solispensa/Chocotone/reference/GP5Editor_files/arial-yellow.png

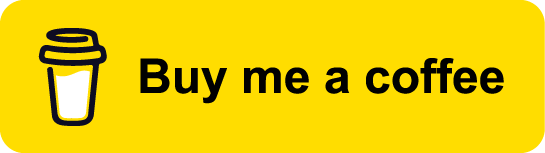
reference/GP5Editor_files/arial-yellow.png
