solispensa/Chocotone/installer.html

# CHOCOTONE

ESP32 FIRMWARE INSTALLER

## Install Firmware

Connect your ESP32 board via USB and click the button below.

Firmware Version:

🚀 Install Chocotone

⚠️

Your browser doesn't support Web Serial. Use Chrome, Edge, or Brave on desktop.

🔒

Serial access blocked. This page must be served over HTTPS or localhost.

📋 What You Need

💻 Chrome, Edge, or Brave

🔌 USB data cable

📦 ESP32 dev board

🪟 Win / Mac / Linux

📝 How It Works

1

### Connect ESP32

Plug your ESP32 board into your computer with a USB data cable.

2

### Select Version

Choose a firmware version from the dropdown (latest recommended).

3

### Click Install

Click the button and select your ESP32 from the list.

4

### Done!

Wait ~30s. Your controller is ready when OLED shows "Chocotone".

🔧 Troubleshooting

ESP32 not showing in the device list

Use a data cable, not charge-only. Try another USB port. On Windows, install CP210x drivers (https://www.silabs.com/developers/usb-to-uart-bridge-vcp-drivers).

Installation fails or times out

Hold the BOOT button on your ESP32 while clicking "Install". Release after programming starts.

"Failed to connect" error

Close other programs using the serial port (Arduino IDE, etc.). Unplug/replug the ESP32 and try again.

Browser shows "Not supported"

Web Serial only works in Chrome, Edge, Brave, Arc, or Opera. Firefox and Safari are not supported.

### 📥 Alternative Download

Prefer to flash manually with Arduino IDE or esptool?

⬇️ Download .bin

GitHub (https://github.com/solispensa/Chocotone) · Beginner's Guide · Community (https://www.facebook.com/groups/1950814575859830/)

Made with ❤️ for the MIDI community
