solispensa/Chocotone/web_tools/installer.html

# CHOCOTONE

ESP32 FIRMWARE INSTALLER

## Install Firmware

Connect your ESP32 board via USB and click the button below.

Firmware Version:

🚀 Install Chocotone

⚠️

Your browser doesn't support Web Serial. Use Chrome, Edge, or Brave.

🔒

Serial access blocked. Must serve over HTTPS or localhost.

📋 What You Need

💻 Chrome / Edge / Brave

🔌 USB data cable

📦 ESP32 dev board

🪟 Win / Mac / Linux

📝 How It Works

1

### Connect ESP32

Plug your ESP32 board into your computer with a USB data cable.

2

### Select Version

Choose the latest firmware version from the dropdown.

3

### Click Install

Click the button and select your ESP32 from the list.

4

### Done!

Wait ~30s. Controller is ready when OLED shows "Chocotone".

🔧 Troubleshooting

ESP32 not showing in list

Use a data cable, not charge-only. Try another USB port. Windows users: install CP210x drivers (https://www.silabs.com/developers/usb-to-uart-bridge-vcp-drivers).

Installation fails / Packet Error

Hold the BOOT button on your ESP32 while clicking "Install". Release after "Erasing" appears.

"Failed to connect"

Close Arduino IDE or other serial monitors. Unplug/replug the ESP32 and try again.

### 📥 Manual Download

Flash manually with esptool?

⬇️ Download .bin

📝 Editor · 🎮 Virtual Chocotone · 📦 GitHub (https://github.com/solispensa/Chocotone)

Beginner's Guide · Community (https://www.facebook.com/groups/1950814575859830/)

Made with ❤️ for the MIDI community
