solispensa/Chocotone/Chocotone_v1.5.0_beta/Storage.cpp

#include "Storage.h"
#include "AnalogInput.h"
#include "DefaultPresets.h"
#include <SPIFFS.h>

#define PRESETS_NAMESPACE "midi_presets"
#define CONFIG_VERSION_KEY "cfg_ver"
#define CURRENT_CONFIG_VERSION 4 // v4: Added Expression Pedal support

// ============================================
// SYSTEM SETTINGS (v2)
// ============================================

void saveSystemSettings() {
  Serial.println("=== Saving System Settings (v2) ===");

  // Use a FRESH LOCAL Preferences object to avoid global state issues
  Preferences prefs;
  if (!prefs.begin(PRESETS_NAMESPACE, false)) {
    Serial.println("ERROR: Cannot open presets namespace for system settings!");
    return;
  }

  // Write version marker (prefixed to avoid collision with preset version)
  prefs.putInt("sys_ver", CURRENT_CONFIG_VERSION);

  // UI Settings (prefixed with "s_" to distinguish from preset data)
  prefs.putInt("s_font", buttonNameFontSize);
  prefs.putInt("s_ledOn", ledBrightnessOn);
  prefs.putInt("s_ledDim", ledBrightnessDim);
  prefs.putInt("s_ledTap", ledBrightnessTap);
  prefs.putInt("s_debounce", buttonDebounce);
  prefs.putInt("s_rhythm", rhythmPattern);
  prefs.putInt("s_delay", currentDelayType);
  prefs.putInt("s_preset", currentPreset);
  prefs.putInt("s_presCnt", presetCount); // v1.5.2: Preset count (1-8)

  // SystemConfig struct fields
  prefs.putString("s_bleName", systemConfig.bleDeviceName);
  prefs.putString("s_apSSID", systemConfig.apSSID);
  prefs.putString("s_apPass", systemConfig.apPassword);
  prefs.putInt("s_btnCount", systemConfig.buttonCount);
  prefs.putBytes("s_btnPins", systemConfig.buttonPins,
                 sizeof(systemConfig.buttonPins));
  prefs.putInt("s_ledPin", systemConfig.ledPin);
  prefs.putInt("s_encA", systemConfig.encoderA);
  prefs.putInt("s_encB", systemConfig.encoderB);
  prefs.putInt("s_encBtn", systemConfig.encoderBtn);
  prefs.putBool("s_wifiBoot", systemConfig.wifiOnAtBoot);
  prefs.putUChar("s_bleMode", (uint8_t)systemConfig.bleMode);
  prefs.putUChar("s_ledsPerBtn", systemConfig.ledsPerButton);
  prefs.putBytes("s_ledMap", systemConfig.ledMap, sizeof(systemConfig.ledMap));

  // OLED Configuration (v1.5)
  prefs.putBytes("s_oledCfg", &oledConfig, sizeof(OledConfig));

  // v1.5 Additions
  prefs.putBytes("s_muxCfg", &systemConfig.multiplexer,
                 sizeof(MultiplexerConfig));
  prefs.putUChar("s_target", (uint8_t)systemConfig.targetDevice);
  prefs.putUChar("s_midiCh", systemConfig.midiChannel);
  prefs.putBool("s_debugAin", systemConfig.debugAnalogIn);
  prefs.putUChar("s_ainCount", systemConfig.analogInputCount);
  prefs.putUChar("s_battPin", systemConfig.batteryAdcPin); // v1.5: Battery ADC
  prefs.putInt("s_batMax", batteryAdcMax); // Auto-calibrated max
  prefs.putInt("s_batMin", batteryAdcMin); // Auto-calibrated min

  Serial.printf("Saved OLED config: type=%d, rotation=%d\n", oledConfig.type,
                oledConfig.rotation);

  prefs.end();
  Serial.println("=== System Settings Saved (v2) ===");
}

void loadSystemSettings() {
  // Use a FRESH LOCAL Preferences object (consistent with saveSystemSettings)
  yield(); // Feed watchdog before NVS operation
  Preferences prefs;
  if (!prefs.begin(PRESETS_NAMESPACE, true)) {
    Serial.println("ERROR: Cannot open presets namespace for loading!");
    return;
  }

  // Check for new format (sys_ver key) or old format
  int version = prefs.getInt("sys_ver", 0); // New unified format
  if (version == 0) {
    // Try old format - might not exist yet
    version = 1;
  }
  Serial.printf("Loading System Settings (v%d)...\n", version);

  // UI Settings (prefixed keys in new format)
  buttonNameFontSize = prefs.getInt("s_font", 5);
  ledBrightnessOn = prefs.getInt("s_ledOn", 220);
  ledBrightnessDim = prefs.getInt("s_ledDim", 20);
  ledBrightnessTap = prefs.getInt("s_ledTap", 240);
  buttonDebounce = prefs.getInt("s_debounce", 120);
  rhythmPattern = prefs.getInt("s_rhythm", 0);
  if (rhythmPattern < 0 || rhythmPattern > 3)
    rhythmPattern = 0;
  currentDelayType = prefs.getInt("s_delay", 0);
  currentPreset = prefs.getInt("s_preset", 0);
  if (currentPreset < 0 || currentPreset >= CHOCO_MAX_PRESETS)
    currentPreset = 0;
  presetCount = prefs.getInt("s_presCnt", 4); // v1.5.2: Default 4 presets
  if (presetCount < 1)
    presetCount = 1;
  if (presetCount > CHOCO_MAX_PRESETS)
    presetCount = CHOCO_MAX_PRESETS;

  // SystemConfig fields (prefixed keys)
  String s_bleName = prefs.getString("s_bleName", DEFAULT_BLE_NAME);
  strncpy(systemConfig.bleDeviceName, s_bleName.c_str(), 23);
  systemConfig.bleDeviceName[23] = '\0';

  String s_ssid = prefs.getString("s_apSSID", DEFAULT_AP_SSID);
  strncpy(systemConfig.apSSID, s_ssid.c_str(), 23);
  systemConfig.apSSID[23] = '\0';

  String s_pass = prefs.getString("s_apPass", DEFAULT_AP_PASS);
  strncpy(systemConfig.apPassword, s_pass.c_str(), 15);
  systemConfig.apPassword[15] = '\0';

  systemConfig.buttonCount = prefs.getInt("s_btnCount", DEFAULT_BUTTON_COUNT);
  if (systemConfig.buttonCount < 4)
    systemConfig.buttonCount = 4;
  if (systemConfig.buttonCount > MAX_BUTTONS)
    systemConfig.buttonCount = MAX_BUTTONS;

  prefs.getBytes("s_btnPins", systemConfig.buttonPins,
                 sizeof(systemConfig.buttonPins));
  systemConfig.ledPin = prefs.getInt("s_ledPin", NEOPIXEL_PIN);
  systemConfig.encoderA = prefs.getInt("s_encA", DEFAULT_ENCODER_A);
  systemConfig.encoderB = prefs.getInt("s_encB", DEFAULT_ENCODER_B);
  systemConfig.encoderBtn = prefs.getInt("s_encBtn", DEFAULT_ENCODER_BTN);
  systemConfig.wifiOnAtBoot = prefs.getBool("s_wifiBoot", false);
  systemConfig.bleMode = (BleMode)prefs.getUChar("s_bleMode", BLE_CLIENT_ONLY);
  systemConfig.ledsPerButton = prefs.getUChar("s_ledsPerBtn", 1);

  // Load ledMap or use defaults
  if (prefs.getBytesLength("s_ledMap") == sizeof(systemConfig.ledMap)) {
    prefs.getBytes("s_ledMap", systemConfig.ledMap,
                   sizeof(systemConfig.ledMap));
  } else {
    // Default ledMap: {0, 1, 2, 3, 7, 6, 5, 4, 8, 9, 10, 11...}
    uint8_t defaultMap[MAX_BUTTONS] = {0, 1, 2,  3,  7,  6,  5,  4,
                                       8, 9, 10, 11, 12, 13, 14, 15};
    memcpy(systemConfig.ledMap, defaultMap, sizeof(systemConfig.ledMap));
  }

  // Load OLED Configuration (v1.5)
  if (prefs.getBytesLength("s_oledCfg") == sizeof(OledConfig)) {
    prefs.getBytes("s_oledCfg", &oledConfig, sizeof(OledConfig));
    Serial.printf("Loaded OLED config: type=%d, rotation=%d\n", oledConfig.type,
                  oledConfig.rotation);
  } else {
    Serial.println("Using default OLED config (128x64)");
  }

  // Load Multiplexer Configuration (v1.5)
  if (prefs.getBytesLength("s_muxCfg") == sizeof(MultiplexerConfig)) {
    prefs.getBytes("s_muxCfg", &systemConfig.multiplexer,
                   sizeof(MultiplexerConfig));
  } else {
    systemConfig.multiplexer.enabled = false;
    for (int i = 0; i < MAX_BUTTONS; i++)
      systemConfig.multiplexer.buttonChannels[i] = -1;
  }

  systemConfig.targetDevice = (DeviceType)prefs.getUChar("s_target", 0);
  systemConfig.midiChannel = prefs.getUChar("s_midiCh", 1);
  systemConfig.debugAnalogIn = prefs.getBool("s_debugAin", false);
  systemConfig.analogInputCount = prefs.getUChar("s_ainCount", 0);
  systemConfig.batteryAdcPin =
      prefs.getUChar("s_battPin", 0);             // v1.5: Battery ADC
  batteryAdcMax = prefs.getInt("s_batMax", 0);    // Auto-calibrated max
  batteryAdcMin = prefs.getInt("s_batMin", 4095); // Auto-calibrated min

  yield(); // Feed watchdog before closing
  prefs.end();
  Serial.println("=== System Settings Loaded ===");
}

// ============================================
// PRESETS - SPIFFS Storage (v4)
// NVS has ~20KB limit, not enough for 16KB preset data
// SPIFFS has 1MB available in the Huge APP partition
// ============================================

#include <SPIFFS.h>

#define PRESETS_FILE "/presets.bin"

void savePresets() {
  Serial.println("Saving Presets (SPIFFS storage)...");

  // Initialize SPIFFS if needed
  if (!SPIFFS.begin(true)) {
    Serial.println("ERROR: SPIFFS mount failed!");
    return;
  }

  // Open file for writing
  File file = SPIFFS.open(PRESETS_FILE, FILE_WRITE);
  if (!file) {
    Serial.println("ERROR: Failed to open presets file for writing!");
    return;
  }

  // Write version marker
  uint8_t version = CURRENT_CONFIG_VERSION;
  file.write(&version, 1);

  // Write all button configs (4 presets × 10 buttons)
  size_t written = file.write((uint8_t *)buttonConfigs, sizeof(buttonConfigs));
  Serial.printf("  buttonConfigs: %d/%d bytes\n", written,
                sizeof(buttonConfigs));

  // Write preset names
  written = file.write((uint8_t *)presetNames, sizeof(presetNames));
  Serial.printf("  presetNames: %d/%d bytes\n", written, sizeof(presetNames));

  // Write LED modes
  written = file.write((uint8_t *)presetLedModes, sizeof(presetLedModes));
  Serial.printf("  ledModes: %d/%d bytes\n", written, sizeof(presetLedModes));

  // Write sync modes
  written = file.write((uint8_t *)presetSyncMode, sizeof(presetSyncMode));
  Serial.printf("  syncModes: %d/%d bytes\n", written, sizeof(presetSyncMode));

  // Write global special actions
  written =
      file.write((uint8_t *)globalSpecialActions, sizeof(globalSpecialActions));
  Serial.printf("  specials: %d/%d bytes\n", written,
                sizeof(globalSpecialActions));

  // Write config metadata (editor fields)
  file.write((uint8_t *)configProfileName, sizeof(configProfileName));
  file.write((uint8_t *)configLastModified, sizeof(configLastModified));
  Serial.printf("  metadata: configName='%s'\n", configProfileName);

  size_t totalSize = file.size();
  file.close();

  Serial.printf("Presets Saved - %d bytes total\n", totalSize);
}

void loadPresets() {
  Serial.println("Loading Presets (SPIFFS storage)...");

  // Initialize SPIFFS - this can take a while on first boot
  yield(); // Feed watchdog before potentially slow operation
  if (!SPIFFS.begin(true)) {
    Serial.println("ERROR: SPIFFS mount failed!");
    loadFactoryPresets();
    return;
  }

  // Check if file exists
  if (!SPIFFS.exists(PRESETS_FILE)) {
    Serial.println("No presets file found - loading factory defaults");
    loadFactoryPresets();
    savePresets(); // Save defaults to SPIFFS
    return;
  }

  // Open file for reading
  File file = SPIFFS.open(PRESETS_FILE, FILE_READ);
  if (!file) {
    Serial.println("ERROR: Failed to open presets file!");
    loadFactoryPresets();
    return;
  }

  // Read version marker
  uint8_t version = 0;
  file.read(&version, 1);
  Serial.printf("  File version: %d\n", version);

  if (version < CURRENT_CONFIG_VERSION) {
    Serial.println("  Old version - loading defaults and migrating");
    file.close();
    loadFactoryPresets();
    savePresets();
    return;
  }

  size_t read = file.read((uint8_t *)buttonConfigs, sizeof(buttonConfigs));
  yield(); // Feed watchdog after large read
  Serial.printf("  buttonConfigs: %d/%d bytes\n", read, sizeof(buttonConfigs));
  if (read != sizeof(buttonConfigs)) {
    Serial.println("  ERROR: Size mismatch - using defaults");
    file.close();
    loadFactoryPresets();
    return;
  }

  // Read preset names
  file.read((uint8_t *)presetNames, sizeof(presetNames));

  // Read LED modes
  file.read((uint8_t *)presetLedModes, sizeof(presetLedModes));

  // Read sync modes
  file.read((uint8_t *)presetSyncMode, sizeof(presetSyncMode));
  Serial.printf("  Sync Mode: P1=%d P2=%d P3=%d P4=%d\n", presetSyncMode[0],
                presetSyncMode[1], presetSyncMode[2], presetSyncMode[3]);

  // Read global special actions
  size_t specialsRead =
      file.read((uint8_t *)globalSpecialActions, sizeof(globalSpecialActions));
  if (specialsRead == sizeof(globalSpecialActions)) {
    Serial.println("  ✓ Special actions loaded");
  } else {
    Serial.println("  Special actions missing - using defaults");
    for (int i = 0; i < MAX_BUTTONS; i++) {
      globalSpecialActions[i].hasCombo = false;
    }
  }

  // Read config metadata (editor fields) - optional, may not exist in old files
  size_t metadataRead =
      file.read((uint8_t *)configProfileName, sizeof(configProfileName));
  if (metadataRead == sizeof(configProfileName)) {
    file.read((uint8_t *)configLastModified, sizeof(configLastModified));
    Serial.printf("  metadata: configName='%s'\n", configProfileName);
  }

  file.close();
  Serial.println("✓ Presets Loaded from SPIFFS");
}

// initializeGlobalOverrides() removed - globalOverrides no longer used

// ============================================
// ANALOG INPUTS - SPIFFS Storage (v5)
// Migrated from NVS (ExpressionPedals) to SPIFFS for list support
// ============================================

#define ANALOG_FILE "/analog_inputs.bin"

void saveAnalogInputs() {
  Serial.println("Saving Analog Inputs (SPIFFS)...");

  // Initialize SPIFFS
  if (!SPIFFS.begin(true)) {
    Serial.println("ERROR: SPIFFS mount failed!");
    return;
  }

  File file = SPIFFS.open(ANALOG_FILE, FILE_WRITE);
  if (!file) {
    Serial.println("ERROR: Failed to open analog file for writing!");
    return;
  }

  // Version marker
  uint8_t version = 1; // v1 of Analog Input file
  file.write(&version, 1);

  // Write array
  size_t written = file.write((uint8_t *)analogInputs, sizeof(analogInputs));
  Serial.printf("  analogInputs: %d/%d bytes\n", written, sizeof(analogInputs));

  file.close();
  Serial.println("Analog Inputs Saved");
}

void loadAnalogInputs() {
  Serial.println("Loading Analog Inputs...");

  if (!SPIFFS.begin(true)) {
    return;
  }

  if (SPIFFS.exists(ANALOG_FILE)) {
    // === LOAD FROM SPIFFS ===
    File file = SPIFFS.open(ANALOG_FILE, FILE_READ);
    if (!file)
      return;

    uint8_t version = 0;
    file.read(&version, 1);

    // Read directly into struct
    if (version == 1) {
      file.read((uint8_t *)analogInputs, sizeof(analogInputs));
      Serial.println("✓ Analog Inputs loaded from SPIFFS");
    } else {
      Serial.println("Unknown analog file version");
    }
    file.close();

  } else {
    // === MIGRATE FROM NVS (Legacy Expression Pedals) ===
    Serial.println("Migrating legacy Expression Pedals from NVS...");
    Preferences prefs;
    prefs.begin(PRESETS_NAMESPACE, true); // Read-only

    // Migration loop (max 2 pedals, as that was the old limit)
    for (int i = 0; i < 2; i++) {
      String prefix = "exp" + String(i) + "_";
      bool enabled = prefs.getBool((prefix + "en").c_str(), false);

      if (enabled) {
        analogInputs[i].enabled = true;
        analogInputs[i].pin =
            prefs.getUChar((prefix + "pin").c_str(), (i == 0) ? 34 : 35);
        analogInputs[i].inputMode = AIN_MODE_POT;

        // Map legacy CC/Channel to first message
        analogInputs[i].messageCount = 1;
        analogInputs[i].messages[0].action =
            ACTION_PRESS; // Contextual (Continuous)
        analogInputs[i].messages[0].type = CC;
        analogInputs[i].messages[0].data1 =
            prefs.getUChar((prefix + "cc").c_str(), 11);
        analogInputs[i].messages[0].channel =
            prefs.getUChar((prefix + "ch").c_str(), 1);
        analogInputs[i].messages[0].minInput = 0;
        analogInputs[i].messages[0].maxInput = 100;

        // Calibration & config
        analogInputs[i].minVal = prefs.getUShort((prefix + "min").c_str(), 0);
        analogInputs[i].maxVal =
            prefs.getUShort((prefix + "max").c_str(), 4095);
        analogInputs[i].inverted =
            prefs.getBool((prefix + "inv").c_str(), false);
        analogInputs[i].emaAlpha =
            prefs.getFloat((prefix + "alpha").c_str(), DEFAULT_EMA_ALPHA);
        analogInputs[i].hysteresis =
            prefs.getUChar((prefix + "hyst").c_str(), DEFAULT_HYSTERESIS);

        Serial.printf("  Migrated Pedal %d to Analog Input A%d\n", i + 1,
                      i + 1);
      }
    }
    prefs.end();

    // Save to new format immediately
    saveAnalogInputs();
  }
}

// ============================================
// PRESET INDEX
// ============================================

void saveCurrentPresetIndex() {
  Preferences sysPrefs;
  sysPrefs.begin("sys_cfg", false);
  sysPrefs.putInt("preset", currentPreset);
  sysPrefs.end();
}

void loadCurrentPresetIndex() {
  Preferences sysPrefs;
  sysPrefs.begin("sys_cfg", true);
  currentPreset = sysPrefs.getInt("preset", 0);
  sysPrefs.end();
  if (currentPreset < 0 || currentPreset > 3)
    currentPreset = 0;
}
