solispensa/Chocotone/Chocotone_v1.5.0_beta/SysexScrollData.h

#ifndef SYSEX_SCROLL_DATA_H
#define SYSEX_SCROLL_DATA_H

#include <Arduino.h>

// ============================================
// SYSEX SCROLL PARAMETER LISTS
// Stored in PROGMEM to save DRAM
// ============================================

#define SYSEX_SCROLL_MSG_MAX_LEN 48

// SysEx scroll parameter IDs (stored in config)
enum SysexScrollParamId : uint8_t {
  SYSEX_PARAM_NONE = 0,
  SYSEX_PARAM_PITCH_HIGH = 1,
  SYSEX_PARAM_DRV_GAIN = 2,
  SYSEX_PARAM_DLY_FBK = 3,
  SYSEX_PARAM_FX1_RATE = 4,
  SYSEX_PARAM_RVB_MIX = 5,
  SYSEX_PARAM_AMP_GAIN = 6,
  SYSEX_PARAM_PITCH_LOW = 7 // <-- Added
};

// PITCH - HIGH SysEx messages (Sonicake Pocket Master)
// From PocketEdit logs - each message is 41 bytes
// Verified byte-by-byte from PocketEdit output

#define PITCH_HIGH_LIST_SIZE 25
#define PITCH_HIGH_MSG_LEN 41

const uint8_t PROGMEM PITCH_HIGH_DATA[PITCH_HIGH_LIST_SIZE *
                                      PITCH_HIGH_MSG_LEN] = {
    // 0:
    // 8080F0010B00010000000E01010408000600000000000000000000000000000000000000000000F7
    0x80, 0x80, 0xF0, 0x01, 0x0B, 0x00, 0x01, 0x00, 0x00, 0x00, 0x0E, 0x01,
    0x01, 0x04, 0x08, 0x00, 0x06, 0x00, 0x00, 0x00, 0x00, 0x00, 0x00, 0x00,
    0x00, 0x00, 0x00, 0x00, 0x00, 0x00, 0x00, 0x00, 0x00, 0x00, 0x00, 0x00,
    0x00, 0x00, 0x00, 0x00, 0xF7,
    // 1:
    // 8080F0010000010000000E0101040800060000000000000000000000000000000000000800030FF7
    0x80, 0x80, 0xF0, 0x01, 0x00, 0x00, 0x01, 0x00, 0x00, 0x00, 0x0E, 0x01,
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
    0x80, 0x80, 0xF0, 0x0C, 0x05, 0x00, 0x01, 0x00, 0x00, 0x00, 0x0E, 0x01,
    0x01, 0x04, 0x08, 0x00, 0x06, 0x00, 0x00, 0x00, 0x00, 0x00, 0x00, 0x00,
    0x00, 0x00, 0x00, 0x00, 0x00, 0x00, 0x00, 0x00, 0x00, 0x00, 0x00, 0x08,
    0x08, 0x04, 0x01, 0xF7, 0x00,
    // 18:
    // 8080F0030A00010000000E01010408000600000000000000000000000000000000000009000401F7
    0x80, 0x80, 0xF0, 0x03, 0x0A, 0x00, 0x01, 0x00, 0x00, 0x00, 0x0E, 0x01,
    0x01, 0x04, 0x08, 0x00, 0x06, 0x00, 0x00, 0x00, 0x00, 0x00, 0x00, 0x00,
    0x00, 0x00, 0x00, 0x00, 0x00, 0x00, 0x00, 0x00, 0x00, 0x00, 0x00, 0x09,
    0x00, 0x04, 0x01, 0xF7, 0x00,
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

// Include DRV_GAIN data (101 messages)
#include "SysexScrollDrvGain.h"

// Include DLY_FBK data (101 messages)
#include "SysexScrollDlyFbk.h"

// Include FX1_RATE data (100 messages)
#include "SysexScrollFx1Rate.h"

// Include RVB_MIX data (101 messages)
#include "SysexScrollRvbMix.h"

// Include AMP_GAIN data (101 messages)
#include "SysexScrollAmpGain.h"

// Include PITCH_LOW data (25 messages)
#include "SysexScrollPitchLow.h"

// Structure for SysEx scroll list metadata
struct SysexScrollList {
  SysexScrollParamId id;
  uint8_t msgCount;
  uint8_t msgLength;
  const uint8_t *data;
};

// Available SysEx scroll lists
const SysexScrollList sysexScrollLists[] = {
    {SYSEX_PARAM_PITCH_HIGH, PITCH_HIGH_LIST_SIZE, PITCH_HIGH_MSG_LEN,
     PITCH_HIGH_DATA},
    {SYSEX_PARAM_DRV_GAIN, DRV_GAIN_LIST_SIZE, DRV_GAIN_MSG_LEN, DRV_GAIN_DATA},
    {SYSEX_PARAM_DLY_FBK, DLY_FBK_LIST_SIZE, DLY_FBK_MSG_LEN, DLY_FBK_DATA},
    {SYSEX_PARAM_FX1_RATE, FX1_RATE_LIST_SIZE, FX1_RATE_MSG_LEN, FX1_RATE_DATA},
    {SYSEX_PARAM_RVB_MIX, RVB_MIX_LIST_SIZE, RVB_MIX_MSG_LEN, RVB_MIX_DATA},
    {SYSEX_PARAM_AMP_GAIN, AMP_GAIN_LIST_SIZE, AMP_GAIN_MSG_LEN, AMP_GAIN_DATA},
    {SYSEX_PARAM_PITCH_LOW, PITCH_LOW_LIST_SIZE, PITCH_LOW_MSG_LEN,
     PITCH_LOW_DATA}};

const int SYSEX_SCROLL_LIST_COUNT =
    sizeof(sysexScrollLists) / sizeof(sysexScrollLists[0]);

// Get scroll list by param ID
inline const SysexScrollList *getSysexScrollList(SysexScrollParamId id) {
  for (int i = 0; i < SYSEX_SCROLL_LIST_COUNT; i++) {
    if (sysexScrollLists[i].id == id) {
      return &sysexScrollLists[i];
    }
  }
  return nullptr;
}

// Get specific message from list by index
inline const uint8_t *getSysexScrollMessage(SysexScrollParamId id, int index,
                                            uint8_t *outLen) {
  const SysexScrollList *list = getSysexScrollList(id);
  if (!list || index < 0 || index >= list->msgCount) {
    *outLen = 0;
    return nullptr;
  }
  *outLen = list->msgLength;
  return list->data + (index * list->msgLength);
}

#endif // SYSEX_SCROLL_DATA_H
