solispensa/Chocotone/Chocotone_v1.5.0_beta/delay_time_sysex.h

// Complete Delay Time SysEx Lookup Table (20ms - 1000ms)
// All 981 entries from SPM MIDI specification
// Stored in PROGMEM (~37KB in flash)

#ifndef DELAY_TIME_SYSEX_H
#define DELAY_TIME_SYSEX_H

#include <Arduino.h>

const struct {
    uint16_t delayMs;
    uint8_t data[38];  // Max size is 38 bytes
} DELAY_TIME_LOOKUP[] PROGMEM = {
    {20, {0xF0,0x08,0x0D,0x00,0x01,0x00,0x00,0x00,0x0E,0x01,0x01,0x04,0x08,0x00,0x07,0x00,0x00,0x00,0x00,0x00,0x00,0x00,0x01,0x00,0x00,0x00,0x00,0x00,0x00,0x00,0x00,0x00,0x00,0x0A,0x00,0x04,0x01,0xF7}},
    {21, {0xF0,0x02,0x05,0x00,0x01,0x00,0x00,0x00,0x0E,0x01,0x01,0x04,0x08,0x00,0x07,0x00,0x00,0x00,0x00,0x00,0x00,0x00,0x01,0x00,0x00,0x00,0x00,0x00,0x00,0x00,0x00,0x00,0x00,0x0A,0x08,0x04,0x01,0xF7}},
    {22, {0xF0,0x0D,0x0A,0x00,0x01,0x00,0x00,0x00,0x0E,0x01,0x01,0x04,0x08,0x00,0x07,0x00,0x00,0x00,0x00,0x00,0x00,0x00,0x01,0x00,0x00,0x00,0x00,0x00,0x00,0x00,0x00,0x00,0x00,0x0B,0x00,0x04,0x01,0xF7}},
    {23, {0xF0,0x07,0x02,0x00,0x01,0x00,0x00,0x00,0x0E,0x01,0x01,0x04,0x08,0x00,0x07,0x00,0x00,0x00,0x00,0x00,0x00,0x00,0x01,0x00,0x00,0x00,0x00,0x00,0x00,0x00,0x00,0x00,0x00,0x0B,0x08,0x04,0x01,0xF7}},
    {24, {0xF0,0x07,0x08,0x00,0x01,0x00,0x00,0x00,0x0E,0x01,0x01,0x04,0x08,0x00,0x07,0x00,0x00,0x00,0x00,0x00,0x00,0x00,0x01,0x00,0x00,0x00,0x00,0x00,0x00,0x00,0x00,0x00,0x00,0x0C,0x00,0x04,0x01,0xF7}},
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

};

const int DELAY_TIME_LOOKUP_SIZE = sizeof(DELAY_TIME_LOOKUP) / sizeof(DELAY_TIME_LOOKUP[0]);

#endif
