solispensa/Chocotone/Chocotone_v1.5.0_beta/sys_ex_data.cpp

#include "sys_ex_data.h"

// SysEx data for Delay Time (20ms - 1000ms)
// Index is (ms) directly. 0-19 are empty.
const uint8_t PROGMEM delayTimeSysEx[1001][38] = {
    {0},
    {0},
    {0},
    {0},
    {0},
    {0},
    {0},
    {0},
    {0},
    {0},
    {0},
    {0},
    {0},
    {0},
    {0},
    {0},
    {0},
    {0},
    {0},
    {0},
    {0xf0, 0x08, 0x0d, 0x00, 0x01, 0x00, 0x00, 0x00, 0x0e, 0x01, 0x01, 0x04, 0x08, 0x00, 0x07, 0x00, 0x00, 0x00, 0x00, 0x00, 0x00, 0x00, 0x01, 0x00, 0x00, 0x00, 0x00, 0x00, 0x00, 0x00, 0x00, 0x00, 0x00, 0x0a, 0x00, 0x04, 0x01, 0xf7}, // 20 ms
    {0xf0, 0x02, 0x05, 0x00, 0x01, 0x00, 0x00, 0x00, 0x0e, 0x01, 0x01, 0x04, 0x08, 0x00, 0x07, 0x00, 0x00, 0x00, 0x00, 0x00, 0x00, 0x00, 0x01, 0x00, 0x00, 0x00, 0x00, 0x00, 0x00, 0x00, 0x00, 0x00, 0x00, 0x0a, 0x08, 0x04, 0x01, 0xf7}, // 21 ms
    {0xf0, 0x0d, 0x0a, 0x00, 0x01, 0x00, 0x00, 0x00, 0x0e, 0x01, 0x01, 0x04, 0x08, 0x00, 0x07, 0x00, 0x00, 0x00, 0x00, 0x00, 0x00, 0x00, 0x01, 0x00, 0x00, 0x00, 0x00, 0x00, 0x00, 0x00, 0x00, 0x00, 0x00, 0x0b, 0x00, 0x04, 0x01, 0xf7}, // 22 ms
    {0xf0, 0x07, 0x02, 0x00, 0x01, 0x00, 0x00, 0x00, 0x0e, 0x01, 0x01, 0x04, 0x08, 0x00, 0x07, 0x00, 0x00, 0x00, 0x00, 0x00, 0x00, 0x00, 0x01, 0x00, 0x00, 0x00, 0x00, 0x00, 0x00, 0x00, 0x00, 0x00, 0x00, 0x0b, 0x08, 0x04, 0x01, 0xf7}, // 23 ms
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
    {0xf0, 0x0e, 0x0f, 0x00, 0x01, 0x00, 0x00, 0x00, 0x0e, 0x01, 0x01, 0x04, 0x08, 0x00, 0x07, 0x00, 0x00, 0x00, 0x00, 0x00, 0x00, 0x00, 0x01, 0x00, 0x00, 0x00, 0x00, 0x00, 0x00, 0x00, 0x00, 0x08, 0x00, 0x0f, 0x07, 0x04, 0x03, 0xf7}, // 495 ms
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
