solispensa/Chocotone/(commit log)

2025-12-06 Add wiring schematic to README
2025-12-06 Rename ESP32_MIDI folder to Chocotone - update all documentation references
2025-12-06 Fix button pin documentation to match Globals.cpp - update to pins 14,27,26,25,33,32,16,17
2025-12-14 Chocotone v1.1 - BLE Dual-Mode, Web Editor Stability, OLED Menu BLE Toggle
    Features:
    - BLE Dual-Mode support (CLIENT/DUAL/SERVER modes)
    - BLE Mode toggle in OLED menu with auto-reboot on changes
    - Web editor stability improvements (request throttling, heap protection)
    - Gradient Chocotone header in web editor
    - OLED refresh when changing presets via web editor
    Fixes:
    - BLE+WiFi crash fix (proper advertising stop)
    - Special Actions save no longer erases RGB values
    - isAlternate checkbox preserved on Special Actions save
    - Web editor crash prevention with low memory detection
    - Duplicate serverConnected variable linker error
    Updated documentation and changelog
    [BleMidi.cpp, BleMidi.h, Chocotone.ino, Config.h, DefaultPresets.h, Globals.cpp, Globals.h, Input.cpp]
2025-12-14 Add remaining v1.1 features to docs: GPIO config, tap LED blink, font size, preset commands, offline editor
2025-12-14 Add LEDs Per Button feature for LED strip support
    - Added ledsPerButton field to SystemConfig (Globals.h)
    - Button i now controls LEDs from (i*lpb) to ((i+1)*lpb-1)
    - Added LEDs/Btn field in web editor System Config (1-32 range)
    - Persisted via NVS in Storage.cpp
    - Default value 1 (backward compatible with single LED per button)
2025-12-14 Fix LED mapping: restore ledMap for backward compatibility
    - When ledsPerButton=1: uses original ledMap[] for button-to-LED remapping
    - When ledsPerButton>1: uses sequential segments for LED strips
    - This fixes the broken LED ordering on existing single-LED builds
    [UI_Display.cpp]
2025-12-14 Add editable LED Map to System Config
    - Moved ledMap from const global to SystemConfig.ledMap[10]
    - Default: {0,1,2,3,7,6,5,4,8,9} for backward compatibility
    - Added NVS persistence for LED map
    - Added LED Map field in web editor (comma-separated values)
    - When ledsPerButton=1, uses ledMap for button-to-LED remapping
    - When ledsPerButton>1, uses sequential segments for LED strips
2025-12-14 Fix WiFi on crash with safer BLE stopping
    - Added null checks for pScan and pClient before calling methods
    - Wrapped BLE scan/disconnect/stop advertising in try-catch blocks
    - Set doScan=false before attempting to stop scan
    - Prevents crashes when BLE not fully initialized
    [WebInterface.cpp]
2025-12-14 Add tooltip to LED Map field explaining sequential mode
2025-12-14 Move LED Map tip to label text instead of tooltip
2025-12-14 Fix tap tempo unlock: go directly to main screen without text
    [Input.cpp]
2025-12-16 v1.2: Fix dynamic button count (4-10) support for LEDs and OLED display
    [UI_Display.cpp]
2025-12-18 Major NVS fix, action-based saves, web editor improvements
    NVS Persistence Fix:
    - Use fresh LOCAL Preferences objects instead of global systemPrefs
    - Add prefs.remove('presets') before writing to fix putBytes returning 0
    - ESP.restart() after save for clean WiFi reinitialization
    Action-Based Message System:
    - Complete holdMs parsing for LONG_PRESS actions
    - Complete combo.label parsing for COMBO actions
    - All message fields now properly persist
    Web Editor Updates:
    - Replaced error messages with friendly reboot message
    - 'Rebooting device, restart WiFi to continue editing'
    - Device database with templates for Sonicake/Hotone
    Documentation:
    - Updated README with new features (action-based s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
    [BleMidi.cpp, BleMidi.h, Chocotone.ino, DefaultPresets.h, Globals.cpp, Globals.h, Input.cpp, Storage.cpp]
2025-12-18 Add minimal WiFi page + USB Serial config transfer
    - Replace large 50KB web editor with minimal 2KB import/export page
    - Add serial commands: GET_CONFIG, SET_CONFIG_START/CHUNK/END, SET_PRESET
    - Add Web Serial API support to offline_editor_v2.html
    - Full config read/write via USB serial (Chrome/Edge)
    - Real-time preset sync - controller updates when preset changes in editor
    - Fix USB connection status to persist across render cycles
    [Chocotone.ino, WebInterface.cpp, WebInterface.h]
2025-12-18 Add copy/paste buttons for actions in editor
    - Actions now enumerated as Action 1, Action 2, etc.
    - Copy button to clipboard, Paste to replace action
    - Delete button in header row with copy/paste
    - USB connection status now persists across renders
2025-12-19 Organize CC/SysEx pickers by device and add GP-5 SysEx presets
    - CC picker now shows all devices (SPM and GP-5) with [SPM]/[GP5] prefixes
    - Added GP-5 effect parameter CCs (NR, PRE, DST, AMP, MOD, DLY, RVB)
    - Added GP-5 SysEx effect on/off presets (all 10 blocks computed with CRC8)
    - SysEx picker organized by device with proper headers
    - Updated devices_database.js with comprehensive GP-5 CC controls
2025-12-19 Fix BleMode enum casting in serial config handler
    - Fixed compilation error: invalid conversion from 'int' to 'BleMode'
    - Added static_cast<BleMode>() for proper enum type conversion
    [WebInterface.cpp]
2025-12-20 Add BLE config service for wireless editor connection (WIP)
    Firmware:
    - Added BLE Config Service with custom UUIDs for web editor communication
    - Config server runs alongside MIDI client for simultaneous SPM + editor
    - Added shared config functions (buildFullConfigJson, processConfigChunk)
    - Uses same JSON protocol as USB Serial for compatibility
    Web Editor:
    - Added Web Bluetooth API support with twin connection cards
    - USB Serial (purple) and Bluetooth (blue) side-by-side UI
    - Full connect/disconnect/read/send functionality
    ⚠️ WORK IN PROGRESS: Bluetooth connection may fail when device is actively
    scanning for SPM. USB Serial connection is fully functional and recommended.
    Testing req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
    [BleMidi.cpp, BleMidi.h, WebInterface.cpp]
2025-12-20 Fix menu behavior: long press only enters menu, not exits. Menu exit via Save & Exit or Cancel menu items with simple press.
    [Input.cpp]
2025-12-20 Add BLE Config Mode toggle menu item to pause scanning
    Menu item 12 'BLE Config' toggles config mode ON/OFF:
    - When ON: BLE scanning is paused for reliable web editor connection
    - When OFF: Normal BLE scanning resumes
    Files changed:
    - Globals.h: Added bleConfigMode extern
    - BleMidi.cpp: Added bleConfigMode variable and scanning check
    - Input.cpp: Added case 12 handler and numMenuItems=13
    - UI_Display.cpp: Added menu item 12 display with ON/OFF status
2025-12-20 Fix BLE Config feature: bypass security for web editor connections
    Major fixes:
    1. Rewrote toggleBleConfigMode() with comprehensive enter/exit logic:
    - Stops BLE scanning when entering config mode
    - Disconnects client from SPM if connected
    - Stops and restarts advertising with config service UUID
    - Re-enables scanning when exiting config mode
    2. Modified security callbacks:
    - onAuthenticationComplete logs 'Auth skipped' in config mode
    - Prevents confusing 'Auth Failed' messages during config
    3. Added setAccessPermissions to config characteristics:
    - ESP_GATT_PERM_READ | ESP_GATT_PERM_WRITE (no encryption)
    - Allows web browsers to connect without BLE bonding
    To use: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
    [BleMidi.cpp, BleMidi.h, Input.cpp]
2025-12-20 Fix BLE config transfer chunking for complete data transfer
    - Reduced chunk size from 500 to 180 bytes for reliable BLE transfer
    - Added 15ms delay between chunks to prevent buffer overflow
    - Added log showing number of chunks being sent
    - This fixes incomplete config loading (RGB values missing)
    [BleMidi.cpp]
2025-12-20 Disable BLE security during config mode to prevent disconnection
    - Added esp_ble_gap_set_security_param calls to toggle security
    - ESP_LE_AUTH_NO_BOND when entering config mode (no auth required)
    - ESP_LE_AUTH_BOND when exiting config mode (restore security)
    - This prevents the BLE stack from disconnecting during config transfer
    [BleMidi.cpp]
2025-12-20 Fix RGB color field name mismatch between editor and firmware
    [WebInterface.cpp]
2025-12-20 Update branding, presentation, and README special thanks
    - Updated web tools design with Chocotone color palette (lavender #8c81df, mint, cyan)
    - Updated presentation.html with current features:
    - New editor image (chocotone_editor_1v2.png)
    - 3 connectivity methods (WiFi, USB Serial, Bluetooth)
    - 5 button action types (Press, Release, Long Press, Double Tap, Combo)
    - Tap tempo lock mode and R.prev/R.next navigation
    - Expanded OLED menu (11 items)
    - Updated chocotone_slide.html with Montserrat font and new colors
    - Deleted obsolete layout_test.html
    - Added chocotone_header_reference.html as design reference
    - Updated README.md Special Thanks with Morningstar Engineering acknowledgme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
2025-12-20 Update README schematic to v2
2025-12-20 Fix virtual controller button layout and center web config title
2025-12-20 Cleanup images/docs and update schematic reference
2025-12-21 v1.4: Labels for all actions, TAP_TEMPO UI improvements, USB reconnection fix
    [DefaultPresets.h, Globals.cpp, Globals.h, Input.cpp, Input.h, Storage.cpp, UI_Display.cpp, UI_Display.h]
2025-12-21 Add button rows selector and update slider ranges in Virtual Chocotone
2025-12-21 Add Open File button to Import/Export section in offline editor
2025-12-21 Update Buttons # slider to step=1 with range 1-12
2025-12-21 Add Bluetooth Serial (SPP) support for wireless editor connection
2025-12-21 Improve long press handling and prevent false triggers on preset change
    - Defer PRESS action for buttons with LONG_PRESS until release
    - Add buttonConsumed array to block button re-triggers after preset changes
    - Clear all button states when preset changes to prevent false triggers
    - Short press fires on release if hold time < threshold
    - Long press works correctly without triggering PRESS first
    [Globals.cpp, Globals.h, Input.cpp]
2025-12-22 Fix BLE config transfer with request-acknowledge protocol and field consistency
    - Redesigned BLE config transfer to use request-acknowledge protocol instead of streaming
    - Browser now requests each chunk individually via GET_CHUNK:N commands
    - Fixed color field inconsistency: all handlers now use 'rgb' instead of 'color'
    - Added normalizeConfigData() in editor to handle legacy color field mapping
    - Increased BLE transfer reliability - no more dropped notifications
    - All 4 connection types (USB, BT Serial, BLE, WiFi) verified working
    [BleMidi.cpp, WebInterface.cpp]
2025-12-23 Add BLE preset change support - sync preset selection to device via BLE
    - Added SET_PRESET handler in BleMidi.cpp processBleConfigCommand
    - Added extern declarations for currentPreset, displayOLED, updateLeds
    - Fixed duplicate chgPreset function in editor that was overriding BLE version
    - Updated sendPresetToDevice to support both Serial and BLE connections
    [BleMidi.cpp]
2025-12-23 Major update: Menu system, OLED display, default config, and SysEx fix
    Menu System:
    - Renamed Wi-Fi Editor → Wi-Fi LoadCfg, BT Serial → BT SerialEdit
    - Merged BLE Config into BLE Mode as EDIT option (CLIENT→SERVER→EDIT cycle)
    - EDIT mode no longer requires reboot on save
    - Added Factory Reset confirmation submenu with Yes/No options
    OLED Display:
    - Main screen shows BLE mode (EDIT/CLIENT/SERVER) + status (Synced/Scanning)
    - Shows '- WIFI CONFIG -' centered when WiFi is on
    - Shows '- BL Serial -' centered when BT Serial is on
    - LONG_PRESS actions show label or command name instead of just HOLD
    Default Config:
    - Changed navigation from COMBO to LONG_PRESS (700ms) for presets
    - Note p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
    [Chocotone.ino, DefaultPresets.h, Globals.cpp, Globals.h, Input.cpp, UI_Display.cpp]
2025-12-23 Add FAQ and update documentation
    New:
    - FAQ.md with comprehensive Q&A covering Coming Soon features, hardware,
    configuration, MIDI actions, LED modes, troubleshooting, and advanced topics
    - Coming Soon section lists planned features: analog inputs, MIDI USB,
    expression pedals, battery level monitoring
    Updated README:
    - Commercial Use & Ecosystem Support section with donation encouragement
    - Attribution Requirements for commercial products
    - Chocotone Open MIDI Controller System branding guidelines
2025-12-23 Update docs: ESP32 NodeMCU32s, Facebook Group link, community CTA
2025-12-23 Fix compilation error: correct SyncMode enum usage in BleMidi.cpp
    [BleMidi.cpp]
2025-12-23 Fix GP5 sync: use exact SysEx commands from GP5EditorBT.html reference
    - Updated gp5_request_current_preset() with correct raw SysEx command
    - Updated gp5_request_preset_list() with correct raw SysEx command
    - Updated gp5_request_globals() with correct raw SysEx command
    - Added gp5_request_current_preset_number() function
    - Added gp5_parse_preset_effect_states() function
    - Rewrote BleMidi.cpp GP5 parsing for multi-chunk accumulation
    - Effect states now parsed from correct offsets (140, 141, 143)
    - Fixed const pointer cast for ESP32 BLE writeValue() compatibility
    [BleMidi.cpp, GP5Protocol.cpp, GP5Protocol.h]
2025-12-24 fix editor dynamic button initialization
2025-12-24 fix serial config upload - pause BLE scan during transfer
    [WebInterface.cpp]
2025-12-24 Fix virtual Chocotone LED colors and tap tempo blink - Import LED colors from JSON config profiles (editor format) - Added hexToRgb helper to convert hex strings to RGB arrays - Initialize LEDs on pa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
2025-12-24 Fix GP5 sync compilation - correct SysEx struct access
    [BleMidi.cpp]
2025-12-25 Fix GP5 sync: refresh effect states after Chocotone preset change
    When changing GP5 preset via Chocotone command, now requests the new preset state to refresh effect LEDs. Previously sync only worked when GP5 changed preset by itself.
    [DeviceProfiles.cpp, GP5Protocol.cpp]
2025-12-25 Fix GP5 sync: request state after every button action
    When GP5 sync is enabled, now requests effect state after any button action (except tap tempo). This ensures LEDs stay synced for preset changes, effect toggles, and any other GP5 commands. Added to: normal press, deferred press (on release), and long press paths.
    [Input.cpp]
2025-12-25 feat: Add ESP32 Web Installer with automatic firmware builds and version dropdown
2025-12-25 Enhance README with additional supported device
    Updated the description to include Valeton GP-5 as a supported device.
2025-12-25 Fix SCSS formatting via PowerShell
2025-12-28 Fix designer import/export and remove button clamping: Fix property mismatch, add skipRestore, update defaults
2026-01-01 Fix USB/BT JSON parse error and add missing OLED config to export
    [WebInterface.cpp]
2026-01-01 Fix JSON hierarchy and editor merge logic for OLED and Analog Inputs
    [WebInterface.cpp]
2026-01-01 Fix Analog Debug logic, update editor titles, fix compilation error
    [AnalogInput.cpp, AnalogInput.h, Chocotone_v1.5.0_beta.ino, GP5Protocol.cpp, Globals.h, Input.cpp, Storage.cpp, UI_Display.cpp]
2026-01-01 Improve BLE server stability and Windows compatibility
    [BleMidi.cpp, WebInterface.cpp]
2026-01-01 Update README: up to 16 programmable buttons
2026-01-01 Update firmware stack to support up to 16 buttons
2026-01-02 Fix menu command serialization - add MENU_TOGGLE/UP/DOWN/ENTER to getCommandTypeString
    [WebInterface.cpp]
2026-01-02 Fix BLE DUAL mode - restart advertising after scanning
    [BleMidi.cpp]
2026-01-02 Fix DUAL mode - pause scanning when DAW connected to server
    [BleMidi.cpp]
2026-01-03 Sync editor defaults with firmware, add dedicated Analog Debug screen
    Editor changes:
    - Sync default presets with firmware DefaultPresets.h
    - Button 4,7: LONG_PRESS instead of COMBO for preset navigation
    - Button 6: Remove WIFI_TOGGLE combo
    - Note preset: CC#1 values 40-47 instead of NOTE_MOMENTARY
    Firmware v1.5 beta changes:
    - Add dedicated displayAnalogDebug() screen for viewing analog inputs
    - Shows up to 16 values in 2-column grid (A1:0000 format)
    - Only displays ENABLED analog inputs from config profile
    - Press encoder button to exit back to menu
    - Remove old analog overlay from displayOLED() that caused text overlap
    - Clean 128x64 and 128x32 display layouts
2026-01-03 v1.5.0-beta: Update templates, fix editor layout, add GP5 profile
    [Globals.cpp, Globals.h, Input.cpp, UI_Display.cpp, WebInterface.cpp]
2026-01-03 Fix config upload memory error: Increase buffers to 32KB
    [WebInterface.cpp]
2026-01-03 Reduce upload buffer to 20KB to fix ESP32 DRAM overflow
    [WebInterface.cpp]
2026-01-04 Fix showStatus toggle: Add missing parsing in applyConfigJson
    [WebInterface.cpp]
2026-01-04 feat: Enhanced TFT display support & Updated Docs
    - Firmware:
    - Added configurable color strip thickness (colorStripHeight)
    - Fixed color strip growth direction (upwards for bottom row)
    - Synced loading screen layout with Editor OLED preview
    - Improved TFT 128x128 screen layouts (Menu, Tap Tempo)
    - Fixed dot position conflicts in loading screen
    - Editor:
    - Added TFT 128x128 preview support matching firmware layouts
    - Added UI slider for Color Strip Thickness
    - Real-time preview updates for strip thickness
    - Documentation:
    - Updated WIRING.md with separate SPI/I2C sections
    - Added specific Analog Input hardware recommendations
    [Chocotone_v1.5.0_beta.ino, Config.h, Globals.cpp, Globals.h, UI_Display.cpp, UI_Display.h, WebInterface.cpp]
2026-01-05 fix: Complete OLED config sync between editor and firmware
    - Firmware (WebInterface.cpp):
    - Fixed GET_CONFIG handler missing 18 OLED fields
    - Added: bpmSize, bpmY, showColorStrips, colorStripHeight, statusAlign
    - Added: titleAlign, bpmAlign, topRowMap, bottomRowMap
    - Added: showStatus, showTopRow, showBottomRow, topRowAlign, bottomRowAlign
    - Fixed first parse location missing fields
    - Firmware (Globals.cpp):
    - Added color strip fields to all screen initializations
    - Main, Menu, Tap, Overlay screens now have complete defaults
    - Editor (chocotone_midi_editor_v1.5_beta.html):
    - Added OLED type normalization (numeric to string)
    - Added missing field defaults in normalizeConfi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
    [Globals.cpp, WebInterface.cpp]
2026-01-05 perf: Real-time analog loading bar display updates - Add throttled display refresh every 50ms for analog value changes - Only triggers redraw when value changes by >3% (122 ADC units) - Only active w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
2026-01-05 fix: Eliminate analog loading bar display flicker - Add updateAnalogColorStrips() for partial screen updates - Only redraws color strip rectangles, not entire screen - Clears strip area then draws fi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
    [Chocotone_v1.5.0_beta.ino, UI_Display.cpp, UI_Display.h]
2026-01-06 Update firmware v1.5.0-beta and fix LED pin docs
    - Add compiled firmware binary chocotone_v1.5.0-beta.bin
    - Fix LED pin inconsistencies in docs (GPIO 15 -> GPIO 5)
    - Update BEGINNER_GUIDE first-time setup to use online USB editor
2026-01-06 Fix JSON NoMemory error for large config uploads
    - Add heap diagnostics before/after JSON parsing
    - Clear BLE scan results to free memory before parsing
    - Check heap availability before allocating JsonDocument
    - Add PSRAM fallback support for ESP32-WROVER boards
    - Reduce upload buffer to 16KB to leave more heap headroom
    [WebInterface.cpp]
2026-01-06 Fix JSON NoMemory: use zero-copy in-place parsing
    Switched from heap-allocated JsonDocument to in-place parsing where
    ArduinoJson modifies the uploadBuffer directly. This reduces memory
    requirements from ~25KB to ~5KB, fixing OOM on ESP32 with 26KB heap.
    [WebInterface.cpp]
2026-01-07 Unified Global Actions UI, fixed cross copy/paste, and synchronized firmware logic. Updated firmware binaries to v1.5.0-beta.
    [DefaultPresets.h, Input.cpp, WebInterface.cpp]
2026-01-07 v1.5.0-beta: Implement Double Tap, Fix Editor UI crash, Improve Global Override timing
    [Globals.cpp, Globals.h, Input.cpp]
2026-01-07 Fix: Add missing 'now' variable in loop_presetMode
    [Input.cpp]
2026-01-07 Fix: Global Action malfunction (import mismatch and trigger strictness)
    [Input.cpp, WebInterface.cpp]
2026-01-07 Optimize: Throttle BLE scanning during editor activity to improve responsiveness
2026-01-07 Fix: Add missing Global Actions export to JSON (USB/BT)
    [WebInterface.cpp]
2026-01-07 Fix: Global Overrides only block local buttons when actively triggered
    [Input.cpp]
2026-01-07 Fix: Global Actions use separate partner field to avoid Union corruption (Fixed Long Press)
    [Globals.h, Input.cpp, WebInterface.cpp]
2026-01-07 Fix: Remove extra brace causing scope error in Input.cpp
    [Input.cpp]
2026-01-08 Optimize: Fix Preferences consistency, defer rhythm saves, reduce LED updates
    [Chocotone_v1.5.0_beta.ino, Input.cpp, Storage.cpp]
2026-01-08 Optimize: Add DEBUG_INPUT macro for conditional button debug logging
2026-01-09 Fix GP5 sync LED logic - skip immediate LED updates in sync mode
    - Skip updateLeds() on button press when GP5/SPM sync is active (let device response set correct state)
    - Skip updateLeds() on partner button press in sync mode
    - Fix immediate PRESS with 2ND_PRESS to not update ledToggleState in sync mode
    - Fix deferred PRESS to skip LED updates in sync mode
    - Preserve LED states on encoder preset change when GP5 sync is active
    This prevents LEDs from briefly showing wrong state before GP5/SPM response arrives.
    [Input.cpp]
2026-01-10 Fix GP5 sync LED instability - skip local isAlternate toggle in sync mode
    [Input.cpp]
2026-01-14 v1.5.0-beta: Add battery monitoring, fix SPM sync toggle
    [Chocotone_v1.5.0_beta.ino, Globals.cpp, Globals.h, Input.cpp, Storage.cpp, UI_Display.cpp, UI_Display.h, WebInterface.cpp]
2026-01-14 v1.5.0-beta: Improved battery icon, error handling in editor
    [UI_Display.cpp]
2026-01-14 v1.5.0-beta: Clean up debug output, improve battery calibration, add TFT/battery features to README
2026-01-16 fix: global actions MIDI bugs - sendSysex sends to both client/server, global actions export/import channel/data1/data2
    [BleMidi.cpp, WebInterface.cpp]
2026-01-19 Fix 128x160 display type not recognized in JSON parser
    [WebInterface.cpp]
2026-01-20 Fix row alignment to use character-based widths instead of screen-filling
    [UI_Display.cpp]
2026-01-20 Fix row alignment: text now left/center/right aligned within each column stripe
    [UI_Display.cpp]
2026-01-20 Fix token redeclaration error - add missing else clause for horizontal layout
    [UI_Display.cpp]
2026-01-20 Change battery icon to proportional loading bar instead of discrete segments
2026-01-20 Fix JSON parse error: add missing closing brackets in buildFullConfigJson
    [WebInterface.cpp]
2026-01-20 Fix serial config: add battery fields and fix JSON bracket closure
    [WebInterface.cpp]
2026-01-20 Add missing batteryAdcPin to serial config export
    [WebInterface.cpp]
2026-01-21 v1.5 Beta: Editor redesign, rotation fix, global action long press fix, encoder debounce
    [Config.h, Input.cpp, UI_Display.cpp, WebInterface.cpp]
2026-01-22 v1.5.2: Add presetCount, display pins, fix null ptr crash
    [Chocotone_v1.5.0_beta.ino, DefaultPresets.h, Globals.cpp, Globals.h, Input.cpp, Storage.cpp, UI_Display.cpp, WebInterface.cpp]
2026-01-22 v1.5.3: Optimize config export, add size indicator, auto-reboot after save
    Editor:
    - Strip unused fields from button messages (inMin/inMax/min/max/label/partner)
    - Add config size indicator with progress bar (max 16KB)
    - normalizeConfigData adds defaults for older configs
    - prepareExportData optimizes export size
    - Lower LED heap threshold (15K->10K) for TFT+BLE configs
    - Rate-limit heap warning logs (every 5s)
    - Auto-reboot after USB config save for clean state
    - Increase upload buffer to 16KB
    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
    [UI_Display.cpp, WebInterface.cpp]
2026-01-22 v1.5.4: Fix globalSpecialActions index bug in editor export/import
    [WebInterface.cpp]
2026-01-22 v1.5.4: Add SYSEX_SCROLL analog input type (full stack)
    - Added SYSEX_SCROLL to MIDI_COMMANDS array
    - Added SYSEX_SCROLL_PARAMS with 'PITCH - HIGH' list (25 messages)
    - Added parameter dropdown UI for analog input messages
    - Added sysexParam to data1 ID conversion in export
    - Added SYSEX_SCROLL to MidiCommandType enum
    - Added SYSEX_SCROLL parsing in parseCommandType
    - Created SysexScrollData.h with PITCH_HIGH list in PROGMEM (~1KB)
    - Added SYSEX_SCROLL handler in AnalogInput.cpp
    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
2026-01-23 feat: Add SYSEX_SCROLL analog input type for parameter control
    - Add new SYSEX_SCROLL command type to support scrolling through SysEx parameter lists
    - Implement SysexScrollData.h with PITCH - HIGH parameter (25 values) for Pocket Master
    - Add analog input handling for SYSEX_SCROLL in AnalogInput.cpp with PROGMEM message storage
    - Fix analog input enabled flag parsing in WebInterface.cpp (defaults to true for config entries)
    - Update editor to export SYSEX_SCROLL with sysexParam to data1 conversion
    - Fix zero-copy JSON parsing to reduce memory usage during config upload
    - Add workflow guide for adding new SysEx Scroll parameters
    - Messages stored in flash (PROGMEM) to conserve RAM, mapped by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
    [AnalogInput.cpp, SysexScrollData.h, WebInterface.cpp]
2026-01-23 Fix analog input updates and add SYSEX_SCROLL parameter lists for PITCH and DRV GAIN
    [SysexScrollData.h, WebInterface.cpp, WebInterface.h]
2026-01-24 Implement ESP32-S3 Support and Multi-Action Logic
    - Added ESP32-S3 hardware profile in Config.h (Safe Pinout)
    - Implemented Native USB MIDI support for S3
    - Updated BleMidi.cpp to route MIDI to both BLE and USB on S3
    - Refactored Input.cpp to support executing multiple actions per button press
2026-01-24 Update: ESP32-S3 Compatibility, Editor Templates, and Firmware Fixes (v1.5 Beta)
    [BleMidi.cpp, Config.h, Globals.cpp, WebInterface.cpp, WebInterface.h]
2026-01-24 Update: S3 Template Full Config & WIRING.md Guide
2026-01-25 Fix: LED Index bug in Editor (hotfix) and AnalogInput processing
    [AnalogInput.cpp]
2026-01-27 Fixes: LED Index, PC Parsing, Global Actions Persistence, System Settings
    [WebInterface.cpp]
2026-01-27 Fix: Resolve NoMemory error on Classic ESP32 during config upload
    [WebInterface.cpp]
2026-01-27 Fix: Resolve encoder pin conflicts individually, fix NoMemory on ESP32 Classic
    [Chocotone_v1.5.0_beta.ino]
2026-01-27 feat: add DLY-FBK and FX1-RATE SysEx scroll parameters and fix editor synchronization
    [SysexScrollData.h]
2026-01-28 Add new SysEx scroll parameters (Amp Gain, Pitch Low, Rvb Mix) and update editor
2026-01-28 Update docs for v1.5.0: Native USB, S3 wiring, Analog Inputs
2026-01-30 Fix: Resolve pin 255 conflict and isolate Tap Tempo actions; Add Pitch Low SysEx
    [Chocotone_v1.5.0_beta.ino, Input.cpp]
2026-01-31 Fix BLE/USB config parsing and complete analog input export
    - Editor: Add complete parameter merging in BLE and USB config reading
    (presetCount, fsrThreshold, multiplexer, globalSpecialActions, OLED, analogInputs)
    - Editor: Add inputMode to actionType conversion for analog inputs
    - Editor: Add defaults for ledIndex, actionOptions, messages array
    - Firmware: Add missing analog input fields to buildFullConfigJson():
    source, actionType, curve, center, deadzone, rgb, ledIndex
    - Firmware: Add fallback parsing for top-level curve/center/deadzone
    [WebInterface.cpp]
2026-02-03 Fix LED blinking bug: TAP_TEMPO buttons now only blink in tap tempo mode
    Changed condition from 'currentMode == 0 && currentBPM > 0' to
    'currentMode == 0 && inTapTempoMode && currentBPM > 0'.
    Previously, TAP_TEMPO buttons would blink forever because currentBPM
    is initialized to 120 and never reset. Now only blinks while actually
    in tap tempo mode.
    [UI_Display.cpp]
2026-02-03 Fix analog input LED index limit: use NUM_LEDS instead of hardcoded 10
    [AnalogInput.cpp]
2026-02-03 Fix button LED bug: default ledMode to MOMENTARY when not in JSON
    When ledMode field is missing from button config JSON (like for TAP_TEMPO
    buttons), ledMode was uninitialized and contained garbage memory values.
    This caused unpredictable LED behavior - buttons could appear stuck off.
    Now defaults to LED_MOMENTARY when not specified.
    [WebInterface.cpp]
2026-02-03 Fix TAP_TEMPO LED visibility: always show at dim brightness when not blinking
    TAP_TEMPO buttons now have special brightness handling - they always display
    at dim brightness (ledBrightnessDim) when not in tap tempo mode, instead of
    requiring the button to be pressed (MOMENTARY behavior). This ensures they
    remain visible like other toggle buttons.
    [UI_Display.cpp]
2026-02-03 Fix LED not working: initialize isAlternate and messageCount in button config
    Root cause: isAlternate and messageCount were not initialized when parsing
    button configs from JSON. Garbage values caused the msg pointer lookup to
    fail (no matching ACTION_PRESS found when isAlternate=garbage true, or
    messageCount=0 from garbage), resulting in RGB = (0,0,0) and LED off.
    Now explicitly initializing both fields before message parsing.
    [WebInterface.cpp]
2026-02-03 Restore tap tempo blinking forever and fix brightness control; Update README configuration steps
    [UI_Display.cpp]
2026-02-04 v1.5.5: Fix BLE server flicker and OLED display freezing
    - BleMidi.cpp: Simplified BLE server onConnect callback to minimal implementation
    - Removed immediate updateConnParams that caused connection instability
    - Let BLE stack handle advertising/scanning naturally
    - Input.cpp: Fixed menu exit display bug
    - Changed break to return for menu exit cases (0, 1, 7)
    - Prevents displayMenu() from being called after preset screen is drawn
    - Added missing safeDisplayOLED() call for Clear BLE Bonds option
    - UI_Display.cpp: Fixed OLED freeze in BLE client mode
    - Removed static local oledHealthy that shadowed global variable
    - Removed I2C health check from safeDisplayOLED() that interfere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
    [BleMidi.cpp, Input.cpp, UI_Display.cpp]
2026-02-09 Fix intermittent BLE sync + auto-calibrating battery monitor
    [BleMidi.cpp, Chocotone_v1.5.0_beta.ino, Globals.cpp, Globals.h, Input.cpp, Storage.cpp, UI_Display.cpp, WebInterface.cpp]
2026-02-10 Remove LED debug code, pin ESP32 Core v3.1.2 in README
2026-02-10 docs: full documentation revision for v1.5.0-beta-patch-2
    - README: USB MIDI working (not broken), Core v3.1.2, NeoPixel v1.12.0+, TFT library, USB mode in menu/connection tables, updated project structure
    - FAQ: USB MIDI and battery monitoring now available, USB mode in MIDI modes table
    - CHANGELOG: new v1.5.0-beta-patch-2 entry (battery, SysEx scroll, USB MIDI, LED fix)
    - CONTRIBUTING: title fix to Chocotone
    - Beta README: features implemented checklist, expanded file table, USB MIDI in modules/data flow
    - BEGINNER_GUIDE: Core v3.1.2 pinned, NeoPixel v1.12.0+, USB MIDI setup steps
    - HARDWARE: battery voltage divider resistors in BOM
2026-02-10 fix: USB MIDI improvements and cleanup
    - Move Serial.printf before usbMidi calls (CDC/MIDI share TinyUSB stack)
    - Remove invalid usbMidi.flush() calls (not in ESP32 USBMIDI API)
    - Add yield() after USB MIDI sends for TinyUSB processing
    - Improve NOTE_MOMENTARY release: send Note Off for ALL matching messages
    - Add USB_MIDI_ONLY label to setup debug print
    - Remove Button 4 debug dump from setup()
    [BleMidi.cpp, Chocotone_v1.5.0_beta.ino, Input.cpp]
2026-02-10 fix(ui): show Min/Max as percentage (0-100%) matching browser editor
    [Input.cpp, UI_Display.cpp]
